Tynogc/Vacuum-Shield/01_Doku/Arduino mega328pb Pinout.jpg

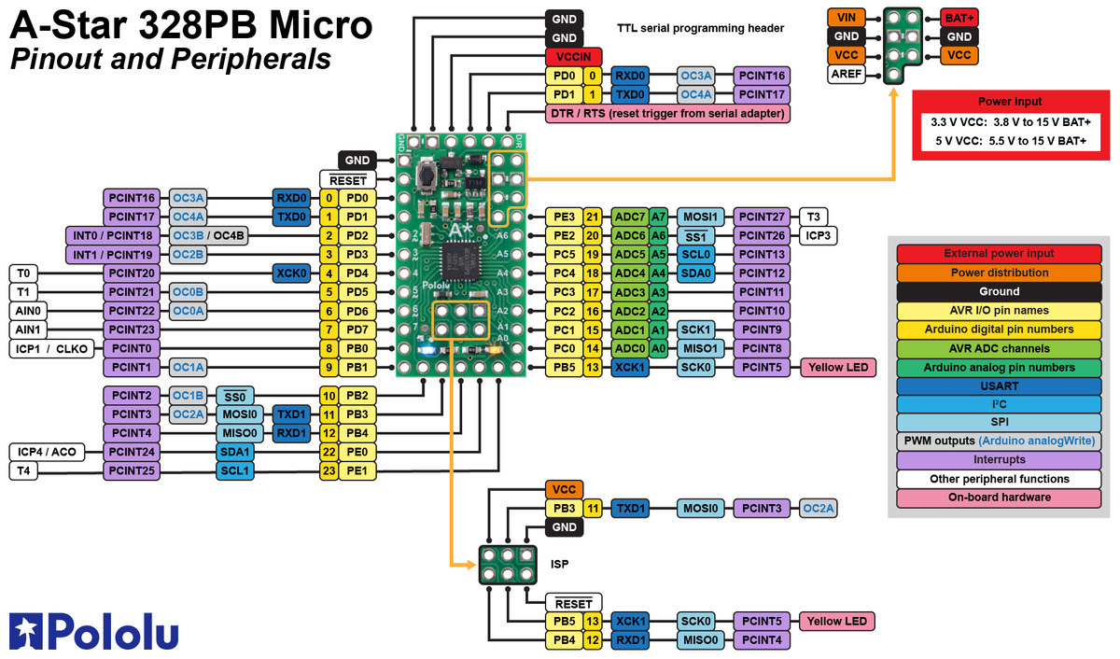
01_Doku/Arduino mega328pb Pinout.jpg
