Tynogc/Vacuum-Shield/01_Doku/siekoo-alphabet_big_CC_BY_NC_ND_4.0.gif

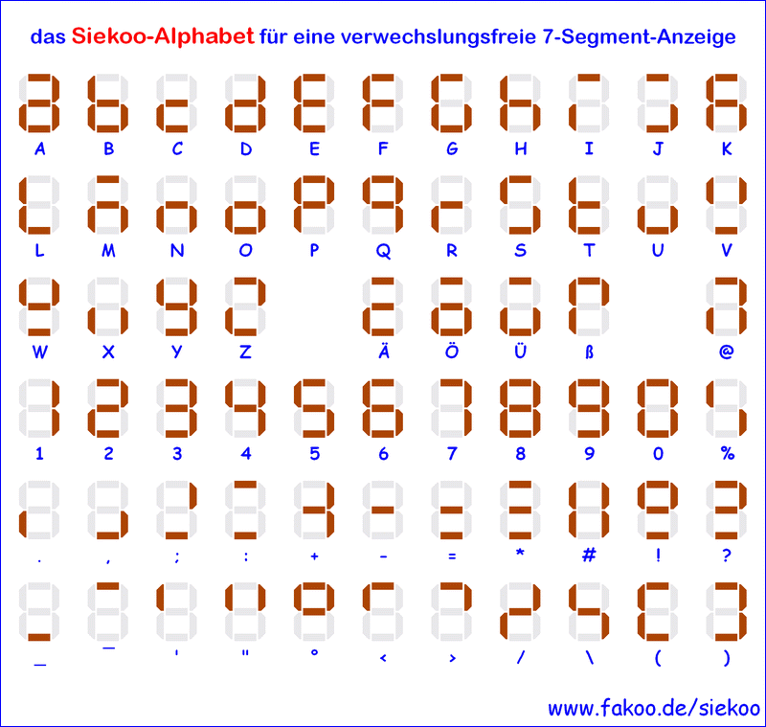
01_Doku/siekoo-alphabet_big_CC_BY_NC_ND_4.0.gif
