Tynogc/Vacuum-Shield/02_Datenblaetter/0.8 Zoll LED Displaydaten.png

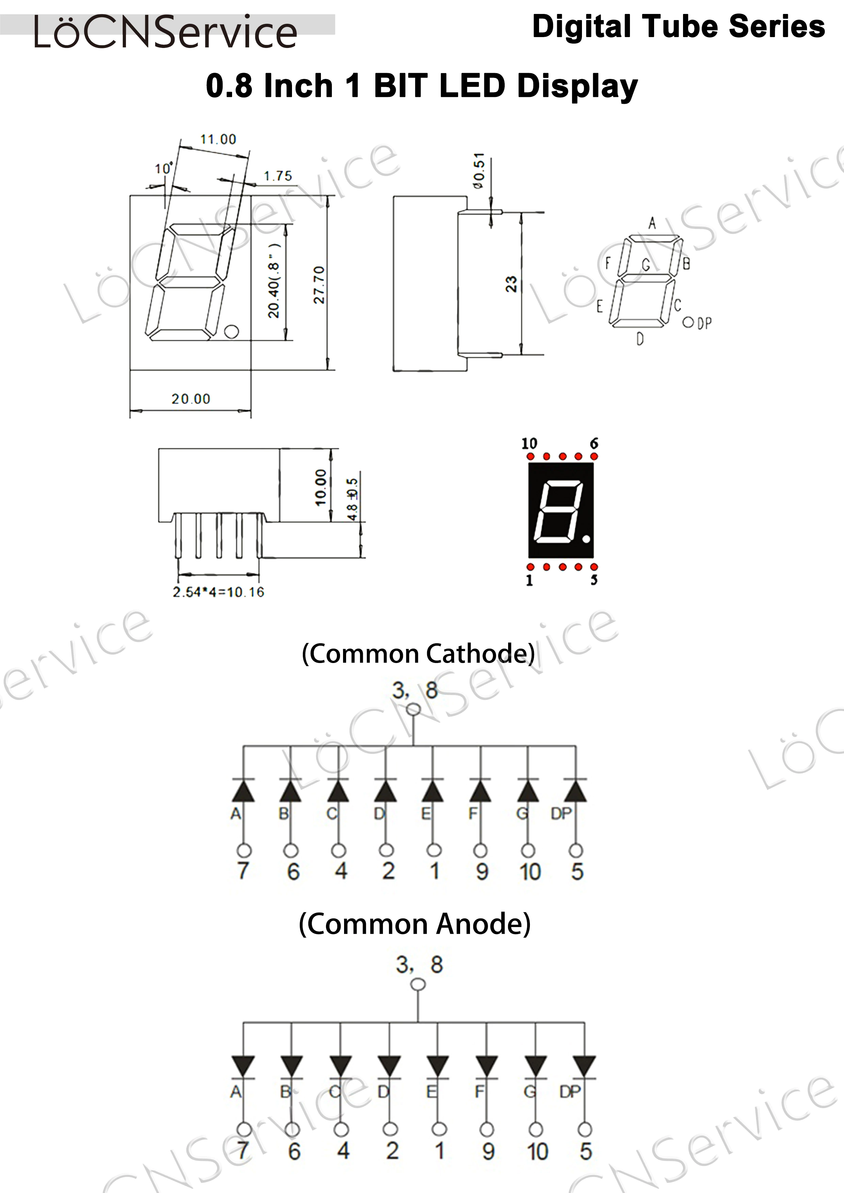
02_Datenblaetter/0.8 Zoll LED Displaydaten.png
