Tynogc/Vacuum-Shield/02_Datenblaetter/0.56 Zoll LED Displaydaten.png

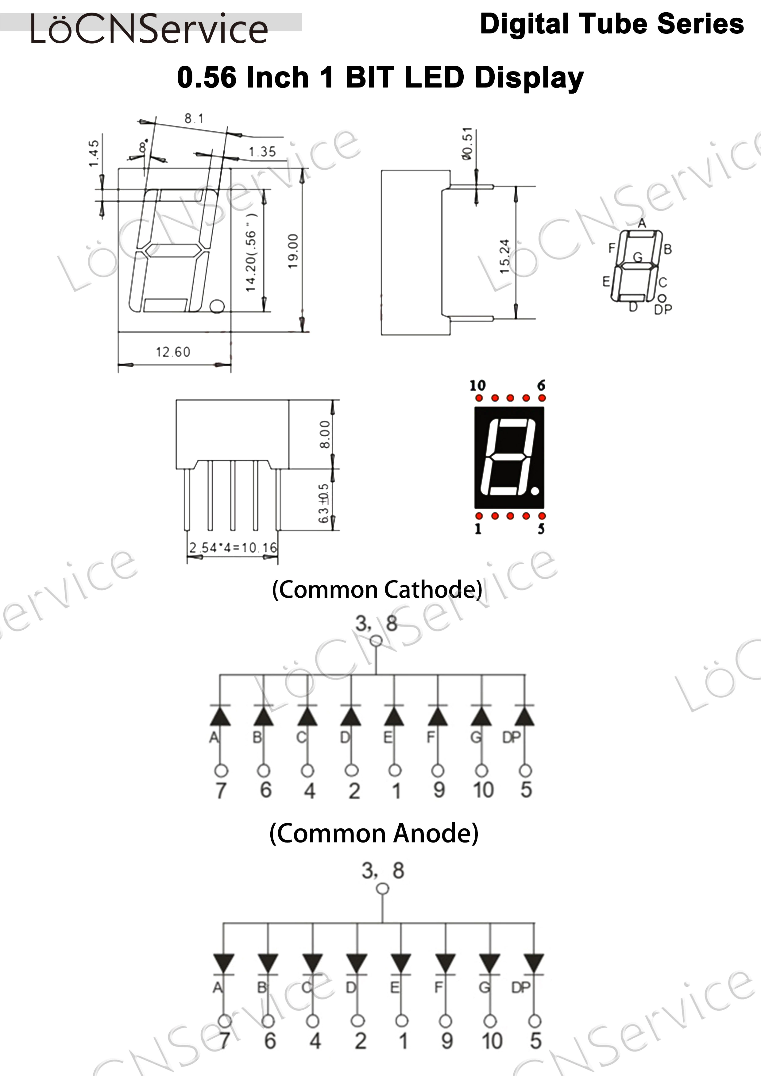
02_Datenblaetter/0.56 Zoll LED Displaydaten.png
