Tynogc/Vacuum-Shield/01_Doku/Material.txt

Photomos:

https://omronfs.omron.com/en_US/ecb/products/pdf/en-g3vm_cr_fr.pdf
https://de.aliexpress.com/item/1005003995602889.html
