Tynogc/Vacuum-Shield/03_Hardware/Drucksensor.kicad_pcb

## KiCad design 03_Hardware/Drucksensor.kicad_pcb (2024-02-26)

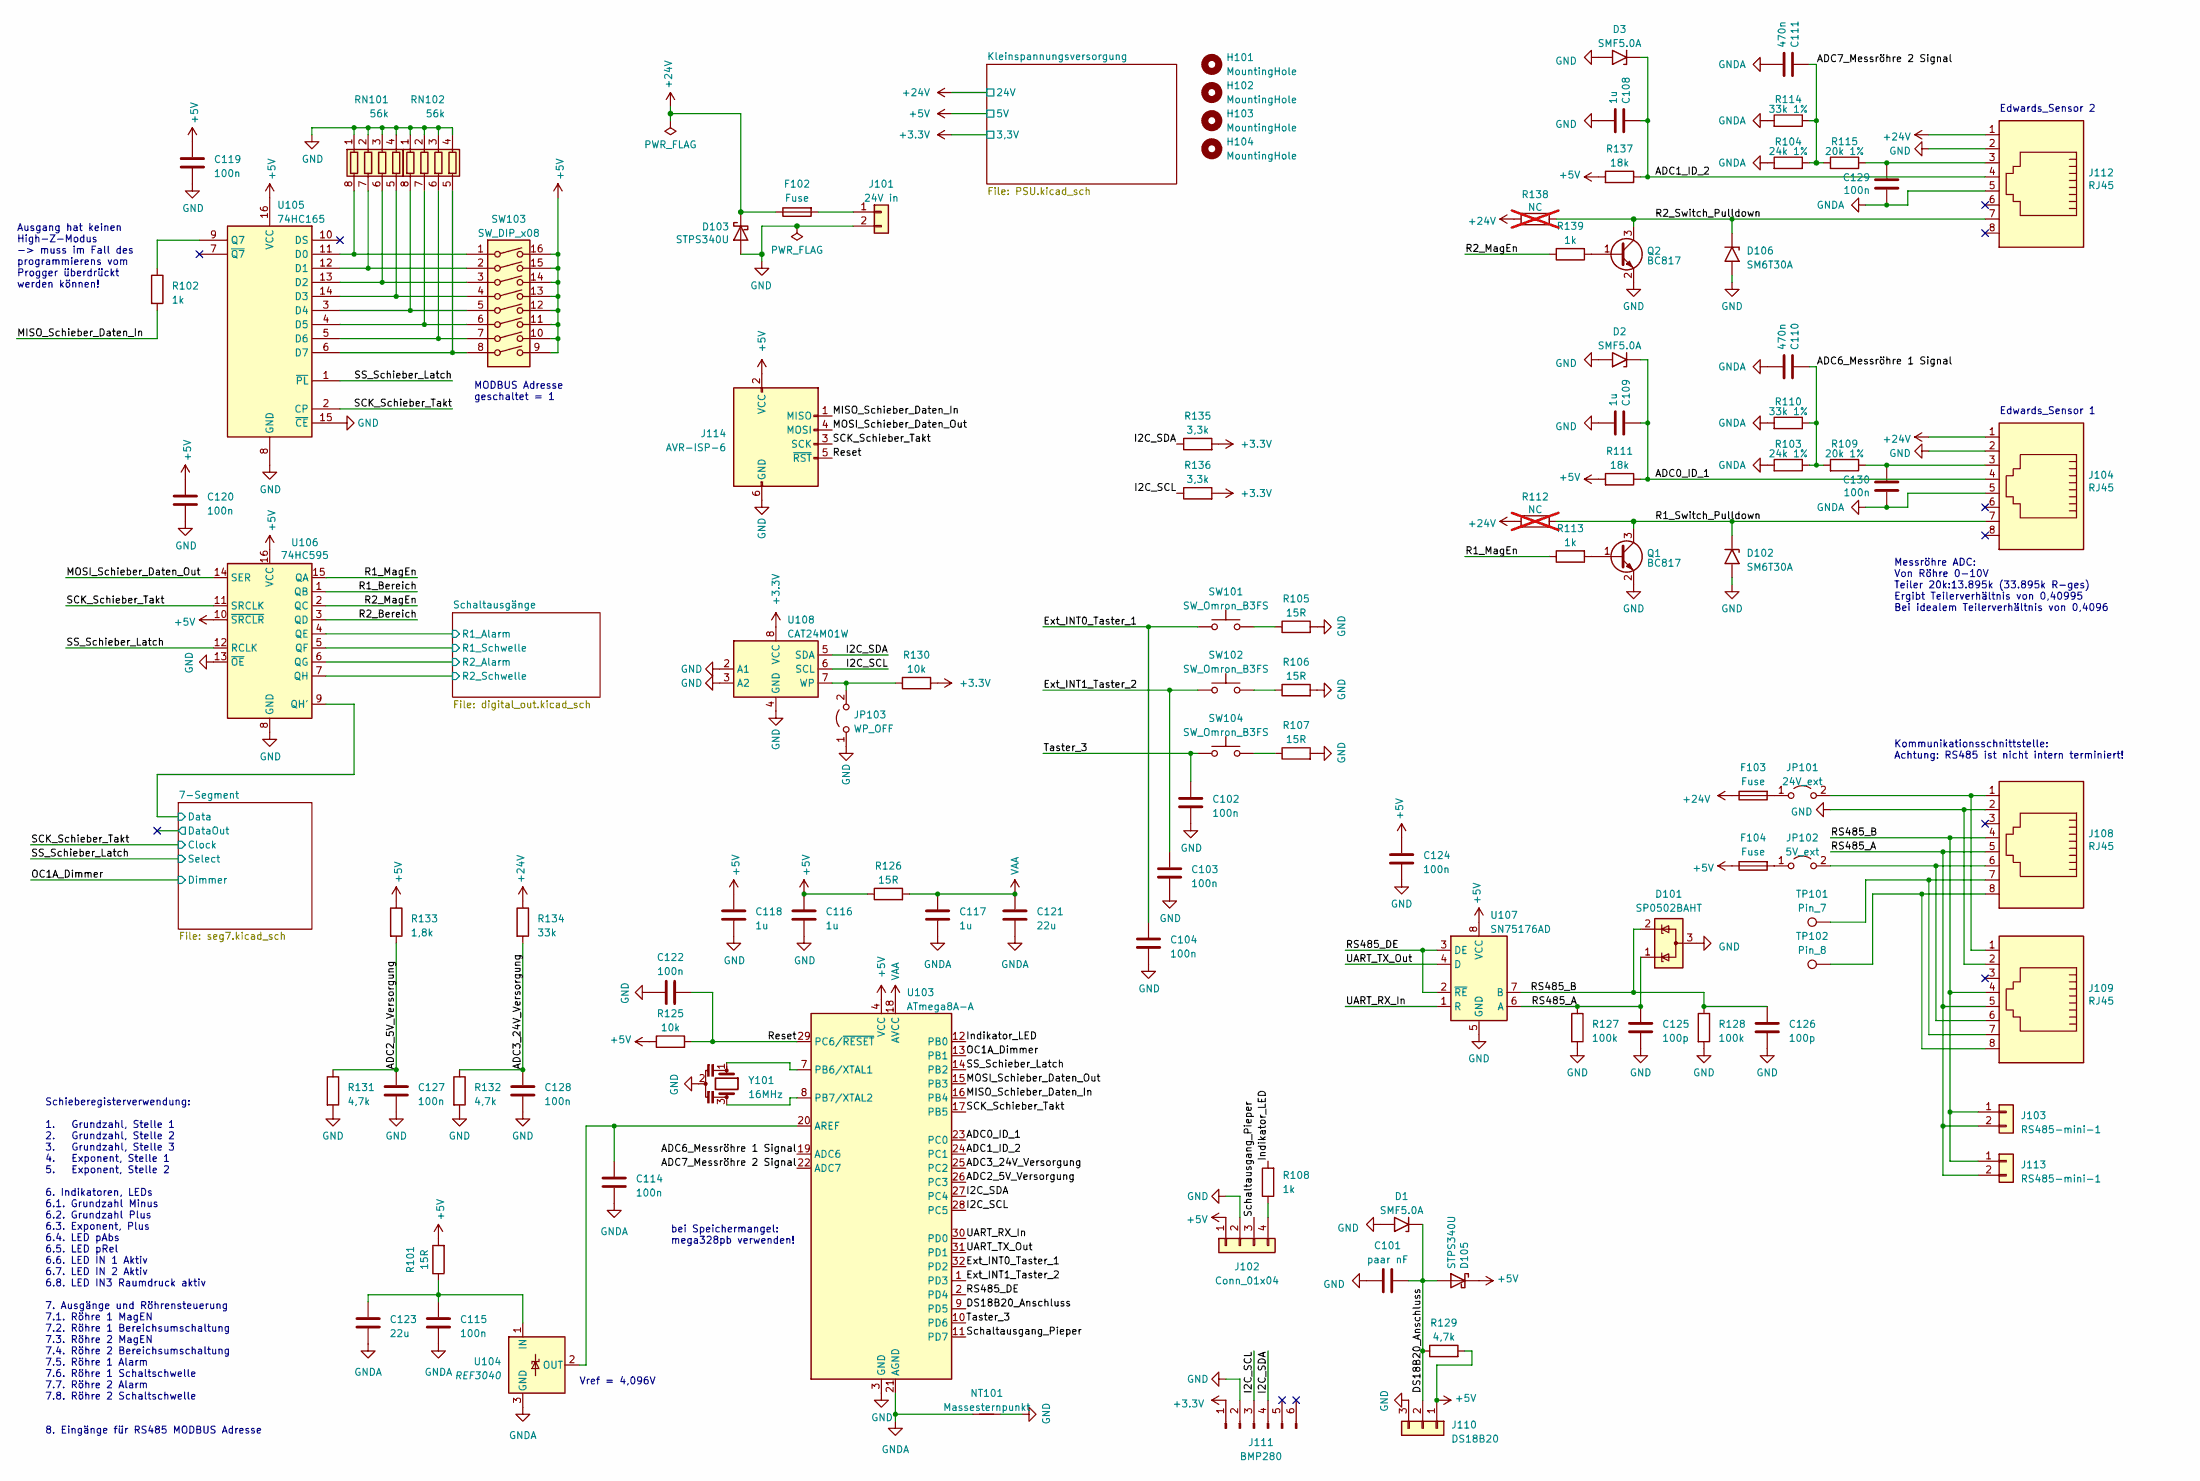
[picture p5: schematic Drucksensor.kicad_sch, Anzeigegerät für zwei aktive Vakuumsensoren]

Parts:
C101: paar nF; C_0603_1608Metric
C102, C103, C104, C114, C115, C119, C120, C122, C124, C127, C128, C129, C130: 100n; C_0603_1608Metric
C108, C109, C116, C117, C118: 1u; C_0603_1608Metric
C110, C111: 470n; C_0603_1608Metric
C121, C123: 22u; C_1206_3216Metric
C125, C126: 100p; C_0603_1608Metric
D1, D2, D3: SMF5.0A; D_SOD-123F
D101: SP0502BAHT; SOT-23
D102, D106: SM6T30A; D_SMB
D103, D105: STPS340U; D_SMB
F102, F103, F104: Fuse; R_1210_3225Metric
H101, H102, H103, H104: MountingHole; MountingHole_3.2mm_M3_DIN965
J101: 24V in; JST_XH_B2B-XH-A_1x02_P2.50mm_Vertical
J102: Conn_01x04; PinHeader_2x02_P2.54mm_Vertical
J103, J113: RS485-mini-1; JST_XH_B2B-XH-AM_1x02_P2.50mm_Vertical
J104, J108, J109, J112: RJ45; RJ45_Amphenol_54602_mod
J110: DS18B20; JST_XH_B3B-XH-AM_1x03_P2.50mm_Vertical
J111: BMP280; PinHeader_1x06_P2.54mm_Vertical
J114: AVR-ISP-6; IDC-Header_2x03_P2.54mm_Vertical
JP101: 24V_ext; PinHeader_1x02_P2.54mm_Vertical
JP102: 5V_ext; PinHeader_1x02_P2.54mm_Vertical
JP103: WP_OFF; PinHeader_1x02_P2.54mm_Vertical
NT101: Massesternpunkt; NetTie-2_SMD_Pad0.5mm
Q1, Q2: BC817; SOT-23
R101, R126: 15R; R_1206_3216Metric
R102, R108, R113, R139: 1k; R_0603_1608Metric
R103, R104: 24k 1%; R_0603_1608Metric
R105, R106, R107: 15R; R_0603_1608Metric
R109, R115: 20k 1%; R_0603_1608Metric
R110, R114: 33k 1%; R_0603_1608Metric
R111, R137: 18k; R_0603_1608Metric
R112, R138: NC; R_1206_3216Metric; not fitted
R125, R130: 10k; R_0603_1608Metric
R127, R128: 100k; R_0603_1608Metric
R129, R131, R132: 4,7k; R_0603_1608Metric
R133: 1,8k; R_0603_1608Metric
R134: 33k; R_0603_1608Metric
R135, R136: 3,3k; R_0603_1608Metric
RN101, RN102: 56k; R_Array_Convex_4x1206; Digikey YC164J-56KCT-ND
SW101, SW102, SW104: SW_Omron_B3FS; SW_PUSH-12mm
SW103: SW_DIP_x08; SW_DIP_SPSTx08_Slide_9.78x22.5mm_W7.62mm_P2.54mm
TP101: Pin_7; TestPoint_Keystone_5005-5009_Compact
TP102: Pin_8; TestPoint_Keystone_5005-5009_Compact
U103: ATmega8A-A; TQFP-32_7x7mm_P0.8mm
U104: REF3040; SOT-23
U105: 74HC165; SOIC-16_3.9x9.9mm_P1.27mm
U106: 74HC595; SOIC-16_3.9x9.9mm_P1.27mm
U107: SN75176AD; SOIC-8_3.9x4.9mm_P1.27mm
U108: CAT24M01W; SOIC-8_3.9x4.9mm_P1.27mm
Y101: 16MHz; Resonator_SMD_Murata_CSTxExxV-3Pin_3.0x1.1mm

Connections:
+3V3: J111.1, R130.2, R135.2, R136.2, U108.8 (VCC); also elsewhere on the board
+5V: C116.1, C118.1, C119.1, C120.1, C124.1, D105.1 (K), F104.1, J102.1, J110.1, J114.2 (VCC), R101.2, R111.2, R125.1, R126.1, R129.2, R133.1, R137.2, SW103.9, SW103.10, SW103.11, SW103.12, SW103.13, SW103.14, SW103.15, SW103.16, U103.4 (VCC), U103.6 (VCC), U105.16 (VCC), U106.10 (~SRCLR), U106.16 (VCC), U107.8 (VCC); also elsewhere on the board
+24V: D103.1 (K), F102.1, F103.1, J104.1, J112.1, R112.1, R134.1, R138.1; also elsewhere on the board
/7-Segment/Data: U106.9 (QH'); also elsewhere on the board
/ADC0_ID_1: C109.1, D2.1 (A1), J104.4, R111.1, U103.23 (PC0)
/ADC1_ID_2: C108.1, D3.1 (A1), J112.4, R137.1, U103.24 (PC1)
/ADC2_5V_Versorgung: C127.1, R131.1, R133.2, U103.26 (PC3)
/ADC3_24V_Versorgung: C128.1, R132.1, R134.2, U103.25 (PC2)
/ADC6_Messröhre 1 Signal: C110.1, R103.1, R109.2, R110.1, U103.19 (ADC6)
/ADC7_Messröhre 2 Signal: C111.1, R104.1, R114.1, R115.2, U103.22 (ADC7)
/DS18B20_Anschluss: C101.2, D1.1 (A1), D105.2 (A), J110.2, R129.1, U103.9 (PD5)
/Ext_INT0_Taster_1: C104.1, SW101.1, U103.32 (PD2)
/Ext_INT1_Taster_2: C103.1, SW102.1, U103.1 (PD3)
/I2C_SCL: J111.3, R136.1, U103.28 (PC5), U108.6 (SCL)
/I2C_SDA: J111.4, R135.1, U103.27 (PC4), U108.5 (SDA)
/Indikator_LED: R108.2, U103.12 (PB0)
/MISO_Schieber_Daten_In: J114.1 (MISO), R102.2, U103.16 (PB4)
/MOSI_Schieber_Daten_Out: J114.4 (MOSI), U103.15 (PB3), U106.14 (SER)
/OC1A_Dimmer: U103.13 (PB1); also elsewhere on the board
/R1_Bereich: U106.1 (QB)
/R1_MagEn: R113.1, U106.15 (QA)
/R1_Switch_Pulldown: D102.1 (A1), J104.7, Q1.3 (C), R112.2
/R2_Bereich: U106.3 (QD)
/R2_MagEn: R139.1, U106.2 (QC)
/R2_Switch_Pulldown: D106.1 (A1), J112.7, Q2.3 (C), R138.2
/RS485_A: C125.1, D101.1 (K), J103.2, J108.5, J109.5, J113.2, R127.1, U107.6 (A)
/RS485_B: C126.1, D101.2 (K), J103.1, J108.4, J109.4, J113.1, R128.1, U107.7 (B)
/RS485_DE: U103.2 (PD4), U107.2 (~RE), U107.3 (DE)
/Reset: C122.2, J114.5 (~RST), R125.2, U103.29 (PC6/~RESET)
/SCK_Schieber_Takt: J114.3 (SCK), U103.17 (PB5), U105.2 (CP), U106.11 (SRCLK); also elsewhere on the board
/SS_Schieber_Latch: U103.14 (PB2), U105.1 (~PL), U106.12 (RCLK); also elsewhere on the board
/Schaltausgang_Pieper: J102.3, U103.11 (PD7)
/Schaltausgänge/R1_Alarm: U106.4 (QE); also elsewhere on the board
/Schaltausgänge/R1_Schwelle: U106.5 (QF); also elsewhere on the board
/Schaltausgänge/R2_Alarm: U106.6 (QG); also elsewhere on the board
/Schaltausgänge/R2_Schwelle: U106.7 (QH); also elsewhere on the board
/Taster_3: C102.1, SW104.1, U103.10 (PD6)
/UART_RX_In: U103.30 (PD0), U107.1 (R)
/UART_TX_Out: U103.31 (PD1), U107.4 (D)
GND: C101.1, C102.2, C103.2, C104.2, C108.2, C109.2, C116.2, C118.2, C119.2, C120.2, C122.1, C124.2, C125.2, C126.2, C127.2, C128.2, D1.2 (A2), D2.2 (A2), D3.2 (A2), D101.3 (A), D102.2 (A2), D103.2 (A), D106.2 (A2), J101.2, J102.2, J104.2, J108.2, J109.2, J110.3, J111.2, J112.2, J114.6 (GND), JP103.1 (A), NT101.2, Q1.2 (E), Q2.2 (E), R105.2, R106.2, R107.2, R127.2, R128.2, R131.2, R132.2, RN101.1 (R1.1), RN101.2 (R2.1), RN101.3 (R3.1), RN101.4 (R4.1), RN102.1 (R1.1), RN102.2 (R2.1), RN102.3 (R3.1), RN102.4 (R4.1), U103.3 (GND), U103.5 (GND), U105.8 (GND), U105.15 (~CE), U106.8 (GND), U106.13 (~OE), U107.5 (GND), U108.2 (A1), U108.3 (A2), U108.4 (GND), Y101.2; also elsewhere on the board
GNDA: C110.2, C111.2, C114.2, C115.2, C117.2, C121.2, C123.2, C129.2, C130.2, J104.5, J112.5, NT101.1, R103.2, R104.2, R110.2, R114.2, U103.21 (AGND), U104.3 (GND)
unnamed: C129.1, J112.3, R115.1
unnamed: C130.1, J104.3, R109.1
unnamed: F102.2, J101.1
unnamed: J102.4, R108.1
unnamed: J108.7, J109.7, TP101.1
unnamed: J108.8, J109.8, TP102.1
unnamed: F103.2, JP101.1 (A)
unnamed: J108.1, J109.1, JP101.2 (B)
unnamed: F104.2, JP102.1 (A)
unnamed: J108.6, J109.6, JP102.2 (B)
unnamed: JP103.2 (B), R130.1, U108.7 (WP)
unnamed: Q1.1 (B), R113.2
unnamed: Q2.1 (B), R139.2
unnamed: R105.1, SW101.2
unnamed: R106.1, SW102.2
unnamed: R107.1, SW104.2
unnamed: RN101.8 (R1.2), SW103.1, U105.11 (D0)
unnamed: RN101.7 (R2.2), SW103.2, U105.12 (D1)
unnamed: RN101.6 (R3.2), SW103.3, U105.13 (D2)
unnamed: RN101.5 (R4.2), SW103.4, U105.14 (D3)
unnamed: RN102.8 (R1.2), SW103.5, U105.3 (D4)
unnamed: RN102.7 (R2.2), SW103.6, U105.4 (D5)
unnamed: RN102.6 (R3.2), SW103.7, U105.5 (D6)
unnamed: RN102.5 (R4.2), SW103.8, U105.6 (D7)
unnamed: C114.1, U103.20 (AREF), U104.2 (OUT)
unnamed: U103.7 (PB6/XTAL1), Y101.1
unnamed: U103.8 (PB7/XTAL2), Y101.3
unnamed: C115.1, C123.1, R101.1, U104.1 (IN)
unnamed: R102.1, U105.9 (Q7)
VAA: C117.1, C121.1, R126.2, U103.18 (AVCC)

Notes on the sheet:
Messröhre ADC: Von Röhre 0-10V Teiler 20k:13.895k (33.895k R-ges) Ergibt Teilerverhältnis von 0,40995 Bei idealem Teilerverhältnis von 0,4096
MODBUS Adresse geschaltet = 1
Edwards_Sensor 2
bei Speichermangel: mega328pb verwenden!
Edwards_Sensor 1
Kommunikationsschnittstelle: Achtung: RS485 ist nicht intern terminiert!
Ausgang hat keinen High-Z-Modus -> muss im Fall des programmierens vom Progger überdrückt werden können!
Schieberegisterverwendung: 1. Grundzahl, Stelle 1 2. Grundzahl, Stelle 2 3. Grundzahl, Stelle 3 4. Exponent, Stelle 1 5. Exponent, Stelle 2 6. Indikatoren, LEDs 6.1. Grundzahl Minus 6.2. Grundzahl Plus 6.3. Exponent, Plus 6.4. LED pAbs 6.5. LED pRel 6.6. LED IN 1 Aktiv 6.7. LED IN 2 Aktiv 6.8. LED 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
Vref = 4,096V

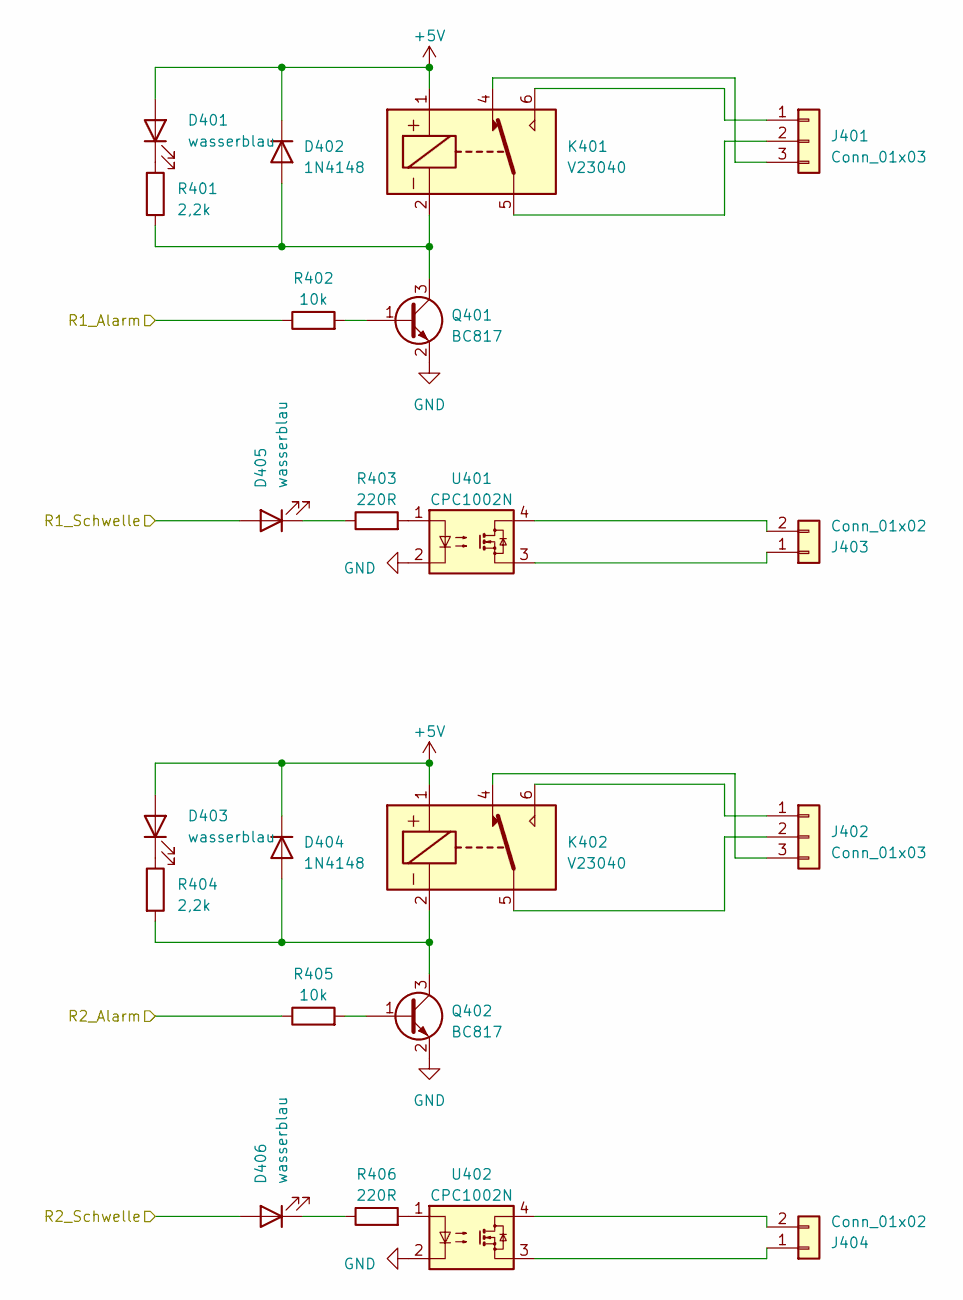
[picture p6: schematic digital_out.kicad_sch, Schaltausgänge für Schaltschwelle und Alarmausgänge]

Parts:
D401, D403, D405, D406: wasserblau; LED_0603_1608Metric
D402, D404: 1N4148; D_MiniMELF
J401, J402: Conn_01x03; Wago_734-133_1x03_P3.50mm_Vertical
J403, J404: Conn_01x02; Wago_734-132_1x02_P3.50mm_Vertical
K401, K402: V23040
Q401, Q402: BC817; SOT-23
R401, R404: 2,2k; R_0603_1608Metric
R402, R405: 10k; R_0603_1608Metric
R403, R406: 220R; R_0603_1608Metric
U401, U402: CPC1002N; SOP-4_3.8x4.1mm_P2.54mm

Connections:
+5V: D401.2 (A), D402.1 (K), D403.2 (A), D404.1 (K), K401.1, K402.1; also elsewhere on the board
/Schaltausgänge/R1_Alarm: R402.1; also elsewhere on the board
/Schaltausgänge/R1_Schwelle: D405.2 (A); also elsewhere on the board
/Schaltausgänge/R2_Alarm: R405.1; also elsewhere on the board
/Schaltausgänge/R2_Schwelle: D406.2 (A); also elsewhere on the board
GND: Q401.2 (E), Q402.2 (E), U401.2, U402.2; also elsewhere on the board
unnamed: D401.1 (K), R401.1
unnamed: D402.2 (A), K401.2, Q401.3 (C), R401.2
unnamed: D403.1 (K), R404.1
unnamed: D404.2 (A), K402.2, Q402.3 (C), R404.2
unnamed: D405.1 (K), R403.1
unnamed: D406.1 (K), R406.1
unnamed: J401.1, K401.6
unnamed: J401.2, K401.5
unnamed: J401.3, K401.4
unnamed: J402.1, K402.6
unnamed: J402.2, K402.5
unnamed: J402.3, K402.4
unnamed: J403.1, U401.3
unnamed: J403.2, U401.4
unnamed: J404.1, U402.3
unnamed: J404.2, U402.4
unnamed: Q401.1 (B), R402.2
unnamed: Q402.1 (B), R405.2
unnamed: R403.2, U401.1
unnamed: R406.2, U402.1

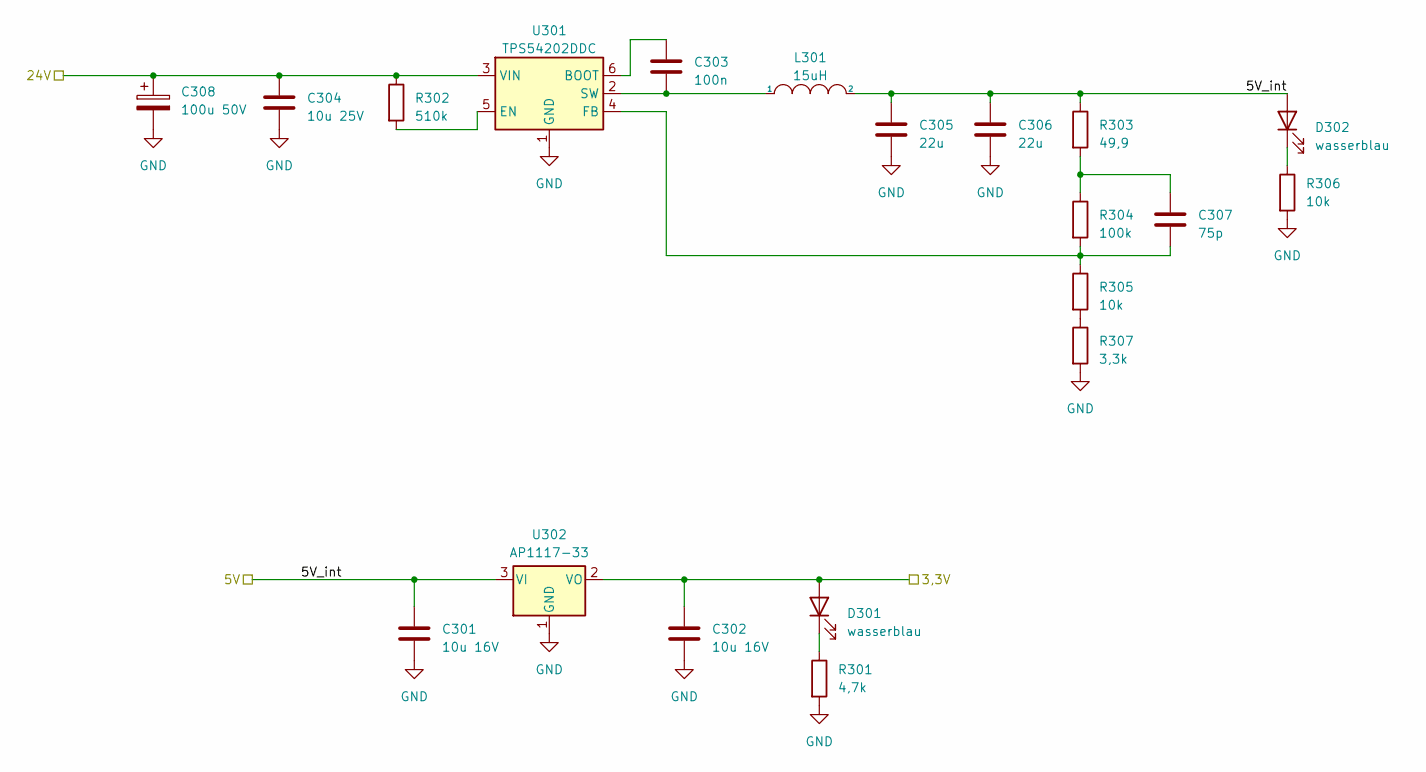
[picture p7: schematic PSU.kicad_sch, Stromversorgung der 5V und 3,3V-Komponenten]

Parts:
C301, C302: 10u 16V; C_1206_3216Metric
C303: 100n; C_0603_1608Metric
C304: 10u 25V; C_1206_3216Metric
C305, C306: 22u; C_1206_3216Metric
C307: 75p; C_0603_1608Metric
C308: 100u 50V; CP_Radial_D8.0mm_P3.50mm
D301, D302: wasserblau; LED_0603_1608Metric
L301: 15uH; L_Bourns-SRN4018
R301: 4,7k; R_0603_1608Metric
R302: 510k; R_0603_1608Metric
R303: 49,9; R_0603_1608Metric
R304: 100k; R_0603_1608Metric
R305, R306: 10k; R_0603_1608Metric
R307: 3,3k; R_0603_1608Metric
U301: TPS54202DDC; SOT-23-6
U302: AP1117-33; SOT-223-3_TabPin2

Connections:
+3V3: C302.1, D301.2 (A), U302.2 (VO); also elsewhere on the board
+5V: C301.1, C305.1, C306.1, D302.2 (A), L301.2, R303.1, U302.3 (VI); also elsewhere on the board
+24V: C304.1, C308.1, R302.1, U301.3 (VIN); also elsewhere on the board
GND: C301.2, C302.2, C304.2, C305.2, C306.2, C308.2, R301.2, R306.2, R307.2, U301.1 (GND), U302.1 (GND); also elsewhere on the board
unnamed: C307.1, R303.2, R304.1
unnamed: D301.1 (K), R301.1
unnamed: D302.1 (K), R306.1
unnamed: R305.2, R307.1
unnamed: C303.1, U301.6 (BOOT)
unnamed: R302.2, U301.5 (EN)
unnamed: C307.2, R304.2, R305.1, U301.4 (FB)
unnamed: C303.2, L301.1, U301.2 (SW)

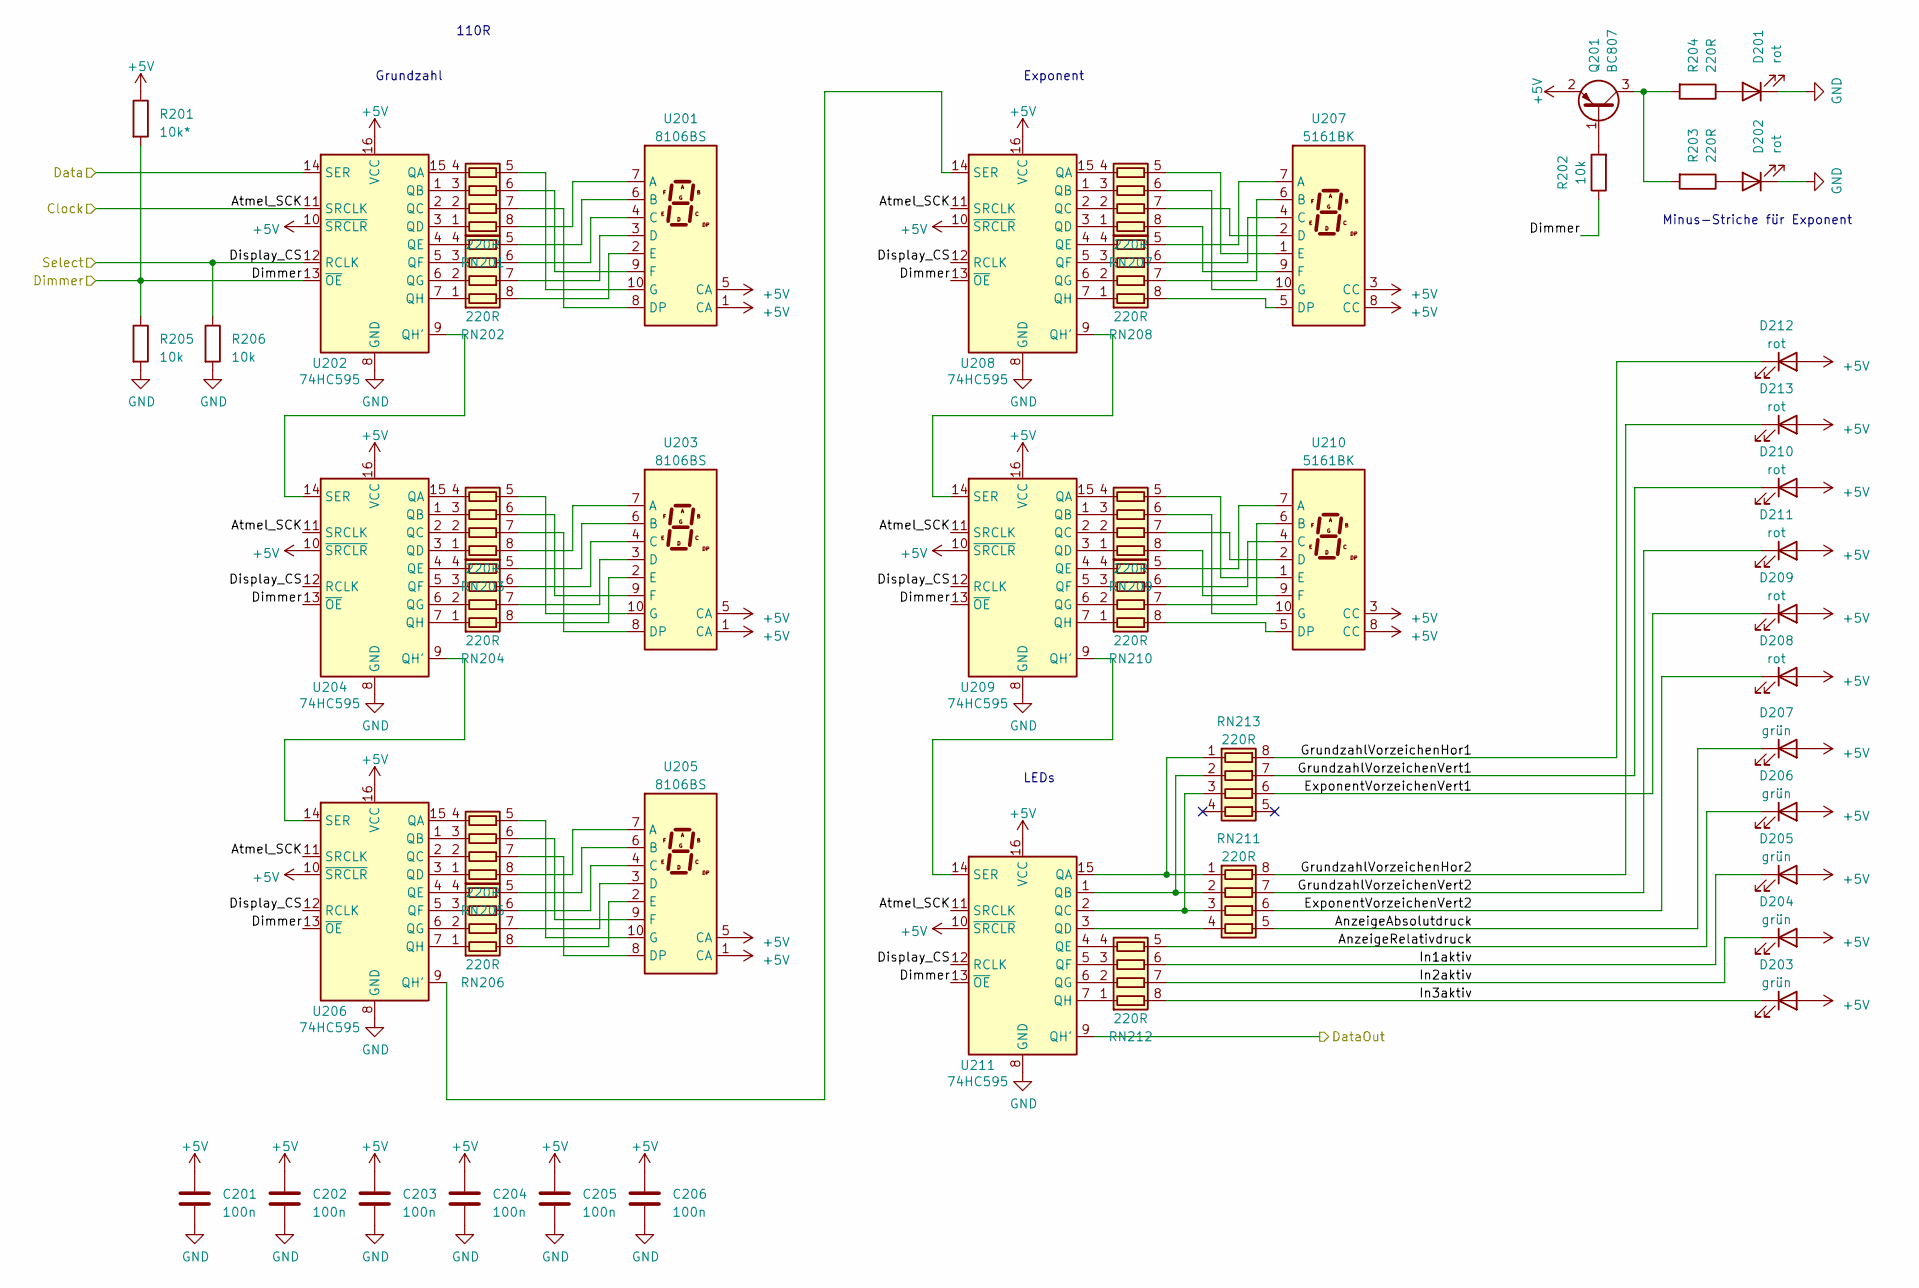
[picture p8: schematic seg7.kicad_sch, LED-Anzeigen und Einzelleds, dimmbar]

Parts:
C201, C202, C203, C204, C205, C206: 100n; C_0603_1608Metric
D201, D202, D208, D209, D210, D211, D212, D213: rot; LED_Rectangular_W3.0mm_H2.0mm
D203, D204, D205, D206, D207: grün; LED_D5.0mm
Q201: BC807; SOT-23
R201: 10k*; R_0603_1608Metric
R202, R205, R206: 10k; R_0603_1608Metric
R203, R204: 220R; R_0603_1608Metric
RN201, RN202, RN203, RN204, RN205, RN206, RN207, RN208, RN209, RN210, RN211, RN212, RN213: 220R; R_Array_Convex_4x1206; Digikey YC164J-220CT-ND
U201, U203, U205: 8106BS
U202, U204, U206, U208, U209, U211: 74HC595; SOIC-16_3.9x9.9mm_P1.27mm
U207, U210: 5161BK; D1X8K

Connections:
+5V: C201.1, C202.1, C203.1, C204.1, C205.1, C206.1, D203.2 (A), D204.2 (A), D205.2 (A), D206.2 (A), D207.2 (A), D208.2 (A), D209.2 (A), D210.2 (A), D211.2 (A), D212.2 (A), D213.2 (A), Q201.2 (E), R201.1, U201.1 (CA), U201.5 (CA), U202.10 (~SRCLR), U202.16 (VCC), U203.1 (CA), U203.5 (CA), U204.10 (~SRCLR), U204.16 (VCC), U205.1 (CA), U205.5 (CA), U206.10 (~SRCLR), U206.16 (VCC), U207.3 (CC), U207.8 (CC), U208.10 (~SRCLR), U208.16 (VCC), U209.10 (~SRCLR), U209.16 (VCC), U210.3 (CC), U210.8 (CC), U211.10 (~SRCLR), U211.16 (VCC); also elsewhere on the board
/7-Segment/AnzeigeAbsolutdruck: D207.1 (K), RN211.5 (R4.2)
/7-Segment/AnzeigeRelativdruck: D206.1 (K), RN212.5 (R4.2)
/7-Segment/Data: U202.14 (SER); also elsewhere on the board
/7-Segment/DataOut: U211.9 (QH')
/7-Segment/ExponentVorzeichenVert1: D209.1 (K), RN213.6 (R3.2)
/7-Segment/ExponentVorzeichenVert2: D208.1 (K), RN211.6 (R3.2)
/7-Segment/GrundzahlVorzeichenHor1: D212.1 (K), RN213.8 (R1.2)
/7-Segment/GrundzahlVorzeichenHor2: D213.1 (K), RN211.8 (R1.2)
/7-Segment/GrundzahlVorzeichenVert1: D210.1 (K), RN213.7 (R2.2)
/7-Segment/GrundzahlVorzeichenVert2: D211.1 (K), RN211.7 (R2.2)
/7-Segment/In1aktiv: D205.1 (K), RN212.6 (R3.2)
/7-Segment/In2aktiv: D204.1 (K), RN212.7 (R2.2)
/7-Segment/In3aktiv: D203.1 (K), RN212.8 (R1.2)
/OC1A_Dimmer: R201.2, R202.1, R205.1, U202.13 (~OE), U204.13 (~OE), U206.13 (~OE), U208.13 (~OE), U209.13 (~OE), U211.13 (~OE); also elsewhere on the board
/SCK_Schieber_Takt: U202.11 (SRCLK), U204.11 (SRCLK), U206.11 (SRCLK), U208.11 (SRCLK), U209.11 (SRCLK), U211.11 (SRCLK); also elsewhere on the board
/SS_Schieber_Latch: R206.1, U202.12 (RCLK), U204.12 (RCLK), U206.12 (RCLK), U208.12 (RCLK), U209.12 (RCLK), U211.12 (RCLK); also elsewhere on the board
GND: C201.2, C202.2, C203.2, C204.2, C205.2, C206.2, D201.1 (K), D202.1 (K), R205.2, R206.2, U202.8 (GND), U204.8 (GND), U206.8 (GND), U208.8 (GND), U209.8 (GND), U211.8 (GND); also elsewhere on the board
unnamed: D201.2 (A), R204.1
unnamed: D202.2 (A), R203.1
unnamed: Q201.1 (B), R202.2
unnamed: Q201.3 (C), R203.2, R204.2
unnamed: RN201.1 (R1.1), U202.3 (QD)
unnamed: RN201.8 (R1.2), U201.7 (A)
unnamed: RN201.2 (R2.1), U202.2 (QC)
unnamed: RN201.7 (R2.2), U201.8 (DP)
unnamed: RN201.3 (R3.1), U202.1 (QB)
unnamed: RN201.6 (R3.2), U201.9 (F)
unnamed: RN201.4 (R4.1), U202.15 (QA)
unnamed: RN201.5 (R4.2), U201.10 (G)
unnamed: RN202.1 (R1.1), U202.7 (QH)
unnamed: RN202.8 (R1.2), U201.2 (E)
unnamed: RN202.2 (R2.1), U202.6 (QG)
unnamed: RN202.7 (R2.2), U201.3 (D)
unnamed: RN202.3 (R3.1), U202.5 (QF)
unnamed: RN202.6 (R3.2), U201.4 (C)
unnamed: RN202.4 (R4.1), U202.4 (QE)
unnamed: RN202.5 (R4.2), U201.6 (B)
unnamed: RN203.1 (R1.1), U204.3 (QD)
unnamed: RN203.8 (R1.2), U203.7 (A)
unnamed: RN203.2 (R2.1), U204.2 (QC)
unnamed: RN203.7 (R2.2), U203.8 (DP)
unnamed: RN203.3 (R3.1), U204.1 (QB)
unnamed: RN203.6 (R3.2), U203.9 (F)
unnamed: RN203.4 (R4.1), U204.15 (QA)
unnamed: RN203.5 (R4.2), U203.10 (G)
unnamed: RN204.1 (R1.1), U204.7 (QH)
unnamed: RN204.8 (R1.2), U203.2 (E)
unnamed: RN204.2 (R2.1), U204.6 (QG)
unnamed: RN204.7 (R2.2), U203.3 (D)
unnamed: RN204.3 (R3.1), U204.5 (QF)
unnamed: RN204.6 (R3.2), U203.4 (C)
unnamed: RN204.4 (R4.1), U204.4 (QE)
unnamed: RN204.5 (R4.2), U203.6 (B)
unnamed: RN205.1 (R1.1), U206.3 (QD)
unnamed: RN205.8 (R1.2), U205.7 (A)
unnamed: RN205.2 (R2.1), U206.2 (QC)
unnamed: RN205.7 (R2.2), U205.8 (DP)
unnamed: RN205.3 (R3.1), U206.1 (QB)
unnamed: RN205.6 (R3.2), U205.9 (F)
unnamed: RN205.4 (R4.1), U206.15 (QA)
unnamed: RN205.5 (R4.2), U205.10 (G)
unnamed: RN206.1 (R1.1), U206.7 (QH)
unnamed: RN206.8 (R1.2), U205.2 (E)
unnamed: RN206.2 (R2.1), U206.6 (QG)
unnamed: RN206.7 (R2.2), U205.3 (D)
unnamed: RN206.3 (R3.1), U206.5 (QF)
unnamed: RN206.6 (R3.2), U205.4 (C)
unnamed: RN206.4 (R4.1), U206.4 (QE)
unnamed: RN206.5 (R4.2), U205.6 (B)
unnamed: RN207.1 (R1.1), U208.3 (QD)
unnamed: RN207.8 (R1.2), U207.9 (F)
unnamed: RN207.2 (R2.1), U208.2 (QC)
unnamed: RN207.7 (R2.2), U207.2 (D)
unnamed: RN207.3 (R3.1), U208.1 (QB)
unnamed: RN207.6 (R3.2), U207.10 (G)
unnamed: RN207.4 (R4.1), U208.15 (QA)
unnamed: RN207.5 (R4.2), U207.1 (E)
unnamed: RN208.1 (R1.1), U208.7 (QH)
unnamed: RN208.8 (R1.2), U207.5 (DP)
unnamed: RN208.2 (R2.1), U208.6 (QG)
unnamed: RN208.7 (R2.2), U207.6 (B)
unnamed: RN208.3 (R3.1), U208.5 (QF)
unnamed: RN208.6 (R3.2), U207.4 (C)
unnamed: RN208.4 (R4.1), U208.4 (QE)
unnamed: RN208.5 (R4.2), U207.7 (A)
unnamed: RN209.1 (R1.1), U209.3 (QD)
unnamed: RN209.8 (R1.2), U210.9 (F)
unnamed: RN209.2 (R2.1), U209.2 (QC)
unnamed: RN209.7 (R2.2), U210.2 (D)
unnamed: RN209.3 (R3.1), U209.1 (QB)
unnamed: RN209.6 (R3.2), U210.10 (G)
unnamed: RN209.4 (R4.1), U209.15 (QA)
unnamed: RN209.5 (R4.2), U210.1 (E)
unnamed: RN210.1 (R1.1), U209.7 (QH)
unnamed: RN210.8 (R1.2), U210.5 (DP)
unnamed: RN210.2 (R2.1), U209.6 (QG)
unnamed: RN210.7 (R2.2), U210.6 (B)
unnamed: RN210.3 (R3.1), U209.5 (QF)
unnamed: RN210.6 (R3.2), U210.4 (C)
unnamed: RN210.4 (R4.1), U209.4 (QE)
unnamed: RN210.5 (R4.2), U210.7 (A)
unnamed: RN211.1 (R1.1), RN213.1 (R1.1), U211.15 (QA)
unnamed: RN211.2 (R2.1), RN213.2 (R2.1), U211.1 (QB)
unnamed: RN211.3 (R3.1), RN213.3 (R3.1), U211.2 (QC)
unnamed: RN211.4 (R4.1), U211.3 (QD)
unnamed: RN212.1 (R1.1), U211.7 (QH)
unnamed: RN212.2 (R2.1), U211.6 (QG)
unnamed: RN212.3 (R3.1), U211.5 (QF)
unnamed: RN212.4 (R4.1), U211.4 (QE)
unnamed: U202.9 (QH'), U204.14 (SER)
unnamed: U204.9 (QH'), U206.14 (SER)
unnamed: U206.9 (QH'), U208.14 (SER)
unnamed: U208.9 (QH'), U209.14 (SER)
unnamed: U209.9 (QH'), U211.14 (SER)

Notes on the sheet:
Exponent
Minus-Striche für Exponent
110R
LEDs
Grundzahl

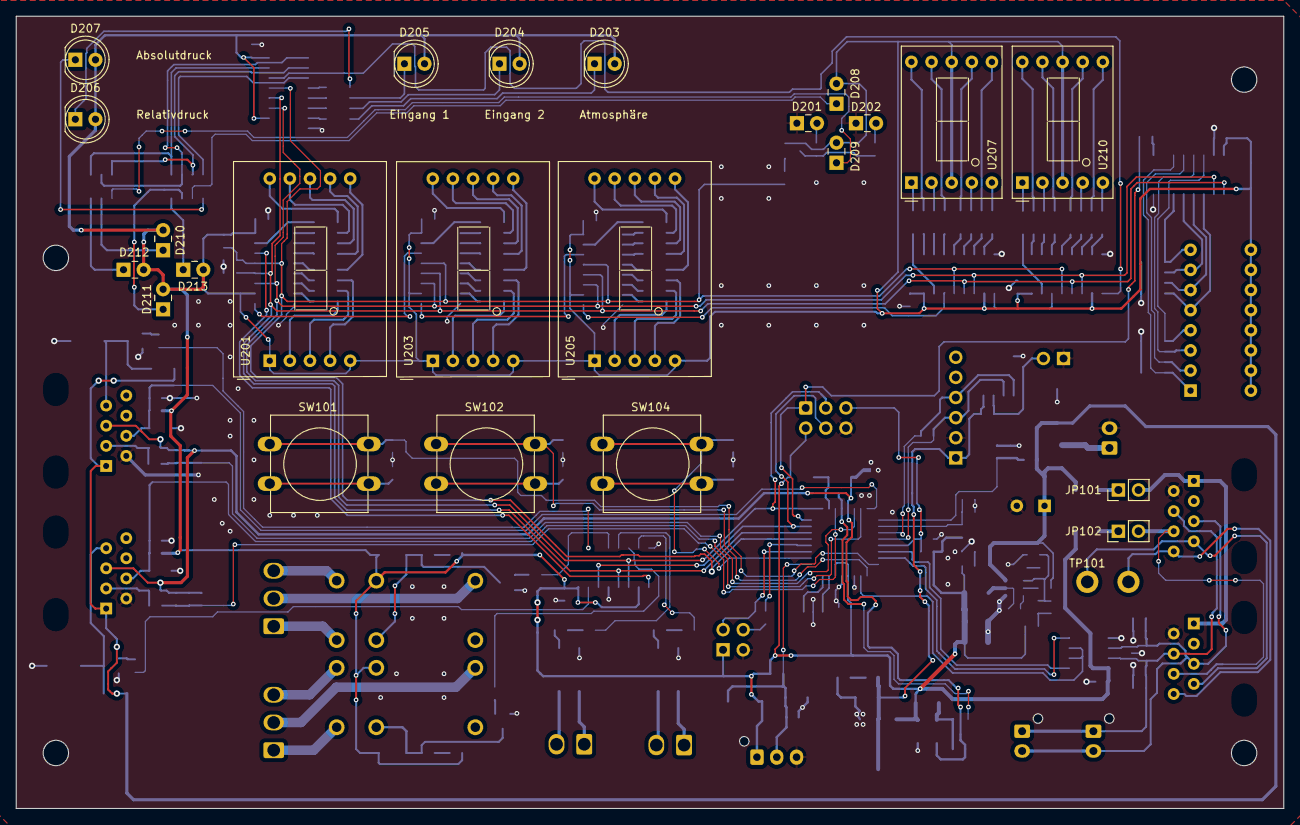
[picture p9: board Drucksensor.kicad_pcb from above]

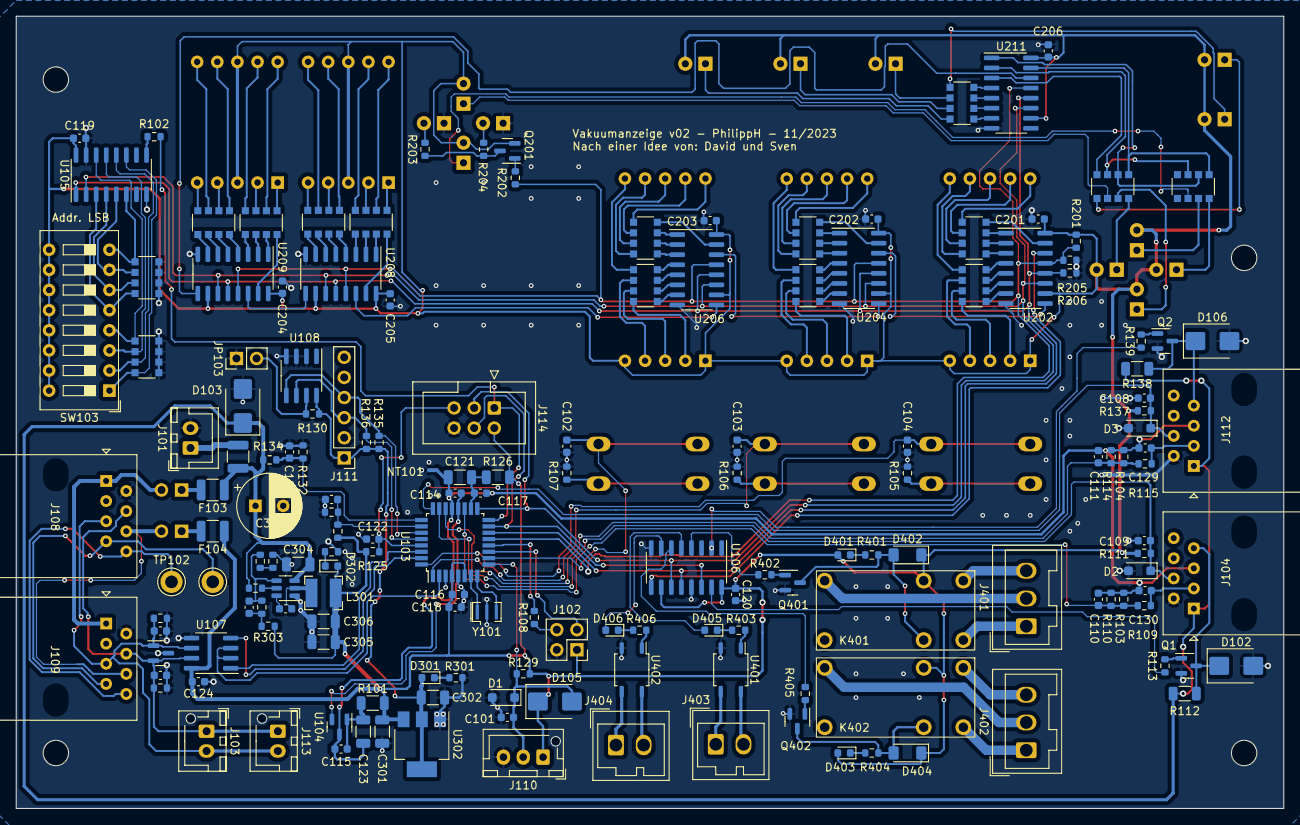
[picture p10: board Drucksensor.kicad_pcb from below]

Board: 2 copper layers, 160.0 x 100.0 mm, 194 parts (167 on the bottom side), 205 nets.
