Tynogc/Vacuum-Shield/(commit log)

2021-09-21 Zweiten Wiederstand zu Spannungsteiler hinzugefügt.
    [Drucksensor.kicad_pcb, Drucksensor.kicad_sch]
2021-09-21 RS232 hinzugefügt
    [Drucksensor.kicad_pcb, Drucksensor.kicad_sch]
2021-09-22 Anschluss für Edwards-Turbopumpe hinzugefügt
    [Drucksensor.kicad_pcb, Drucksensor.kicad_sch]
2021-09-22 Lüfter Eingefügt
    [Drucksensor.kicad_pcb, Drucksensor.kicad_sch]
2021-09-22 Silkscreen angepasst (Lüfter)
    [Drucksensor.kicad_pcb]
2021-09-23 Software-Serial für RS232 interface
    [Drucksensor.kicad_pcb, Drucksensor.kicad_sch]
2021-09-23 Flächen angepasst
    [Drucksensor.kicad_pcb]
2021-09-24 Kondensatoren für V-Ref
    [Drucksensor.kicad_pcb, Drucksensor.kicad_sch]
2021-10-16 Andere Werte für spannungsteiler
    [Drucksensor.kicad_sch]
2021-10-17 Fertigungsdaten und IBOM hinzugefügt
    [Drucksensor-B_Cu.gbl, Drucksensor-B_Mask.gbs, Drucksensor-B_Paste.gbp, Drucksensor-B_Silkscreen.gbo, Drucksensor-Edge_Cuts.gm1, Drucksensor-F_Cu.gtl, Drucksensor-F_Mask.gts, Drucksensor-F_Paste.gtp]
2023-01-01 Lastenheft und Dokument für Materialbeschaffung hinzugefügt
2023-01-01 Ordnerstruktur aufgeräumt
    [Drucksensor-B_Cu.gbl, Drucksensor-B_Mask.gbs, Drucksensor-B_Paste.gbp, Drucksensor-B_Silkscreen.gbo, Drucksensor-Edge_Cuts.gm1, Drucksensor-F_Cu.gtl, Drucksensor-F_Mask.gts, Drucksensor-F_Paste.gtp]
2023-01-01 Datenblätter verwendeter und einiger geplanter Bauteile hinzugefügt
2023-01-01 Lastenheft erweitert und päsizisert. weitere kicad backup-Datei zur ignore hinzugefügt
2023-01-02 Spannungskurvenwerte hinzugefügt, Lastenheft angepasst
    [Edwards_Modelle_2020_23_01_01.ods]
2023-01-11 Anzeigeplan weiter, Datenblatt der 0,56" Anzeige dazugefügt
    [Drucksensor.kicad_sch, seg7.kicad_sch]
2023-01-18 Beschreibungsdatei aktualisiert
    [Edwards_Modelle_2023_01_01.ods, Edwards_Modelle_2023_01_02.ods]
2023-01-22 Schaltplan Main erweitert und PSU/Ausgänge hinzugefügt
    [Drucksensor.kicad_sch, PSU.kicad_sch, digital_out.kicad_sch, seg7.kicad_sch]
2023-01-22 Magnetron Datenblätter hinzugefügt
2023-01-22 Datenblätter von RS485 trx, Flash und AIM-Röhre hinzugefügt
2023-01-22 Schaltplan erweitert, I2C eingebaut
    [Drucksensor.kicad_sch, PSU.kicad_sch, seg7.kicad_sch]
2023-01-22 ADC-Verwendung Betriebsspannungsmessung hinzugefügt
2023-01-22 I2C Pullups hinzugefügt
    [Drucksensor.kicad_sch, Edwards_Modelle_2023_01_02.ods]
2023-01-22 Datenblätter APG und TPS54202 hinzugefügt
2023-01-22 Röhreneingänge angelegt
    Messröhren sind jetzt mit Edwards-Gängiger Beschaltung angelegt.
    [Drucksensor.kicad_sch]
2023-01-23 Schaltwandler für 5V und Linearwandler für 3,3V angelegt
    [PSU.kicad_sch]
2023-01-23 RJ45-Anschlüsse überarbeitet
    [Drucksensor.kicad_sch]
2023-01-23 Datenblatt 3,3V Linearwandler hinzugefügt
2023-01-25 TVS Dioden für Signal und DS18b20 hinzugefügt
    [Drucksensor.kicad_sch, digital_out.kicad_sch]
2023-02-02 Pfeiffer IKR270 hinzugefügt
    [Edwards_Modelle_2023_01_02.ods]
2023-03-03 Datenblätter der beiden LED-7-Segmente hinzugefügt
2023-03-03 Librarys für Schaltplansymbole Relais und LED-Segmente hinzugefügt
2023-03-03 Relais und Photomos eingefügt. TODO: Schraubklemmen!
    [digital_out.kicad_sch]
2023-03-03 Anzeigen an bestellte Modelle angepasst
    [seg7.kicad_sch]
2023-03-03 Reste von altem Projekt gelöscht und neue Daten, so fertig, eingefügt.
    [Drucksensor.kicad_pcb]
2023-03-03 Versionsänderungen 6.99 auf 7.0rc, Übergang alte Version 1 auf Version 2.dev
    [Drucksensor.kicad_sch, PSU.kicad_sch]
2023-03-04 Curve Fit Algo auf Spannungsteiler Detektion Sensor geworfen => 18,8k kamen raus. Jetzt wird es mal mit 18k probiert.
    [Drucksensor.kicad_sch]
2023-03-04 BiDir 5V TVS Diode an ID Leitung Sensor angebracht
    [Drucksensor.kicad_sch]
2023-03-14 Software angefangen - vscode und Platformio, mega328pb
    [Drucksensor.kicad_sch]
2023-03-14 Datenblatt und Arduino-Beschreibung für den mega328pb hinzugefügt
2023-03-15 Folgende Änderungen wurden gelöscht und erneut durchgeführt UniDir 5V TVS Diode an ID Leitung Sensor angebracht Spannungsteiler Detektion Sensor => 18k
    [Drucksensor.kicad_sch]
2023-07-02 kleine änderungen
    [Drucksensor.kicad_pcb, seg7.kicad_sch]
2023-07-29 Layout weitergemacht, RJ45 Buchsen fehlen noch komplett
    [Drucksensor.kicad_pcb, Drucksensor.kicad_sch, PSU.kicad_sch, digital_out.kicad_sch, seg7.kicad_sch]
2023-11-24 Stecker fertig ausgewählt und Layout etwa 60% fertig
    [Drucksensor.kicad_pcb, Drucksensor.kicad_sch, PSU.kicad_sch, digital_out.kicad_sch, seg7.kicad_sch]
2023-11-25 Layout aktuell fast DRC-Fehlerfrei, Überlappungen von Plus-Zeichen sind in Ordnung. Texte müssen noch ausgerichtet werden!
    [Drucksensor.kicad_pcb, Drucksensor.kicad_sch, seg7.kicad_sch]
2023-11-25 Texte ausgerichtet.
    [Drucksensor.kicad_pcb]
2024-02-26 Software weitergemacht
    [Drucksensor.kicad_pcb, Drucksensor.kicad_sch, seg7.kicad_sch]
